DM4DS/MIDI_Box_v1/MIDI_BOX_NUT-heavy VFO.jpg

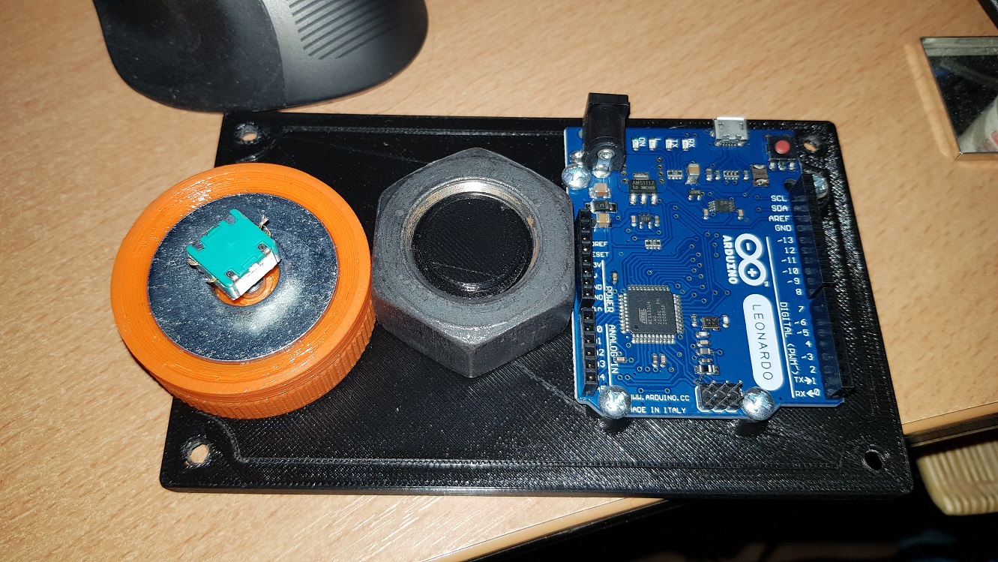
MIDI_BOX_NUT-heavy VFO.jpg
