DM4DS/MIDI_Box_v1/Black Gehäuse MIDI BOX2.jpg

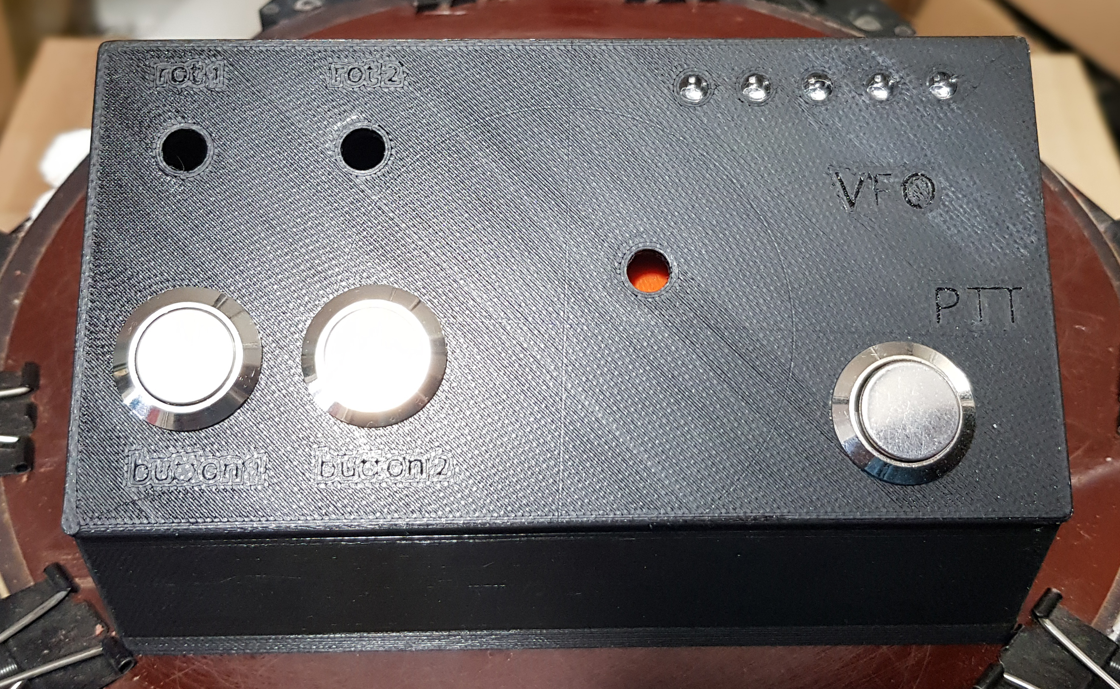
Black Gehäuse MIDI BOX2.jpg
