DM4DS/MIDI_Box_v1/STL Vorlage Gehäuse MIDI BOX.JPG

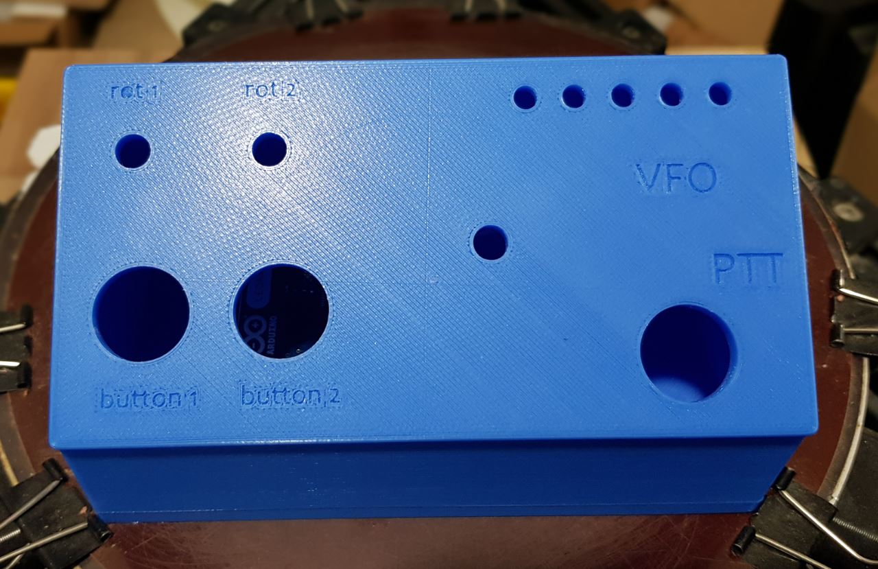
STL Vorlage Gehäuse MIDI BOX.JPG
