DM4DS/MIDI_Box_v1/(commit log)

2021-03-07 Add files via upload
    MIDI_Controller_DM4DS_Bottom ZIPed while unpacked over the 25Mb Github Limit
    MIDI_Controller_DM4DS_Uno_VFO_Button_V2.0_heavy also ZIPed > Limit
    This Heavy VFO Button is modified for usage with big DIN9021 13mm washers! to give the VFO more weigth.
2021-03-19 Uploaded a bottom without the M27 thread
    Some asked me for a version without the M27 thread (for the big nut) for faster printtime and not wasting plastic while not using the thread for a nut and here it is.
    Thanks for the positive feedback
    Sandor
    DM4DS
